AhmedAbdelbasit/ZUMAN-Robot/README.md

# ZUMAN-Robot
This repository will contain the full code and documentation of ZUMAN Robot. It is my graduation project. Here is the youtube playlist for its progress https://goo.gl/xKe8xR
