AhmedAbdelbasit/ZUMAN-Robot/Hardware/Required Arduino Libraries/Readme.txt

put these libraries at path:
	C:\Users\<user>\Documents\Arduino\libraries
	
ros_lib enables you to use ros messages in arduino ide
