AhmedAbdelbasit/ZUMAN-Robot/Documentation/Second version/Fig/Electronics/micro-servo.jpg

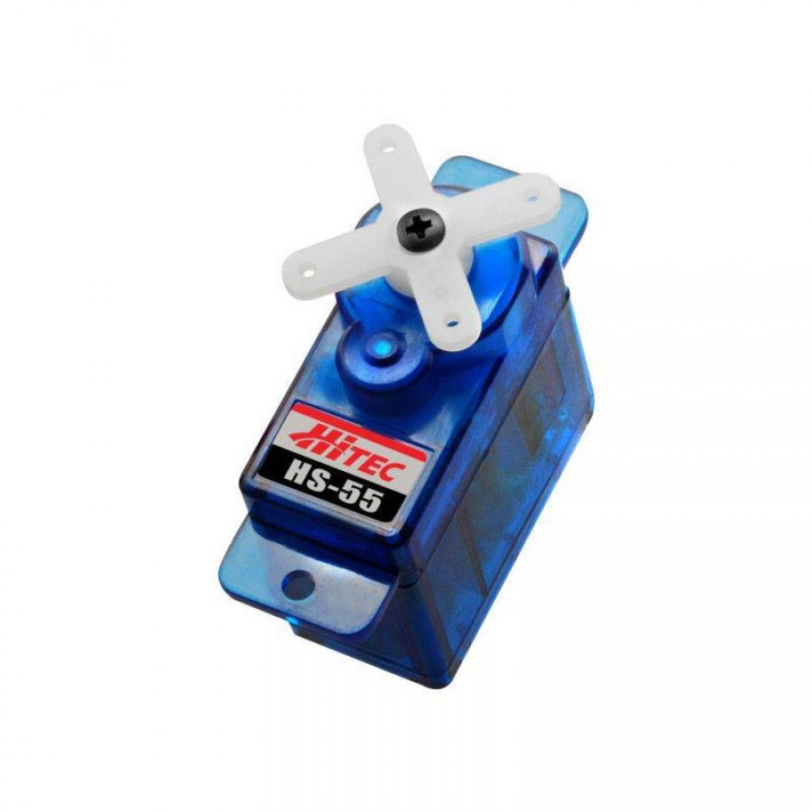
Documentation/Second version/Fig/Electronics/micro-servo.jpg
