AhmedAbdelbasit/ZUMAN-Robot/Documentation/Second version/Fig/Electronics/standard-servo.png

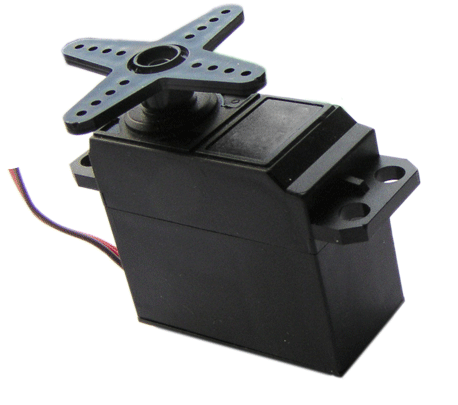
Documentation/Second version/Fig/Electronics/standard-servo.png
