AhmedAbdelbasit/ZUMAN-Robot/Documentation/Second version/Fig/hw-map.png

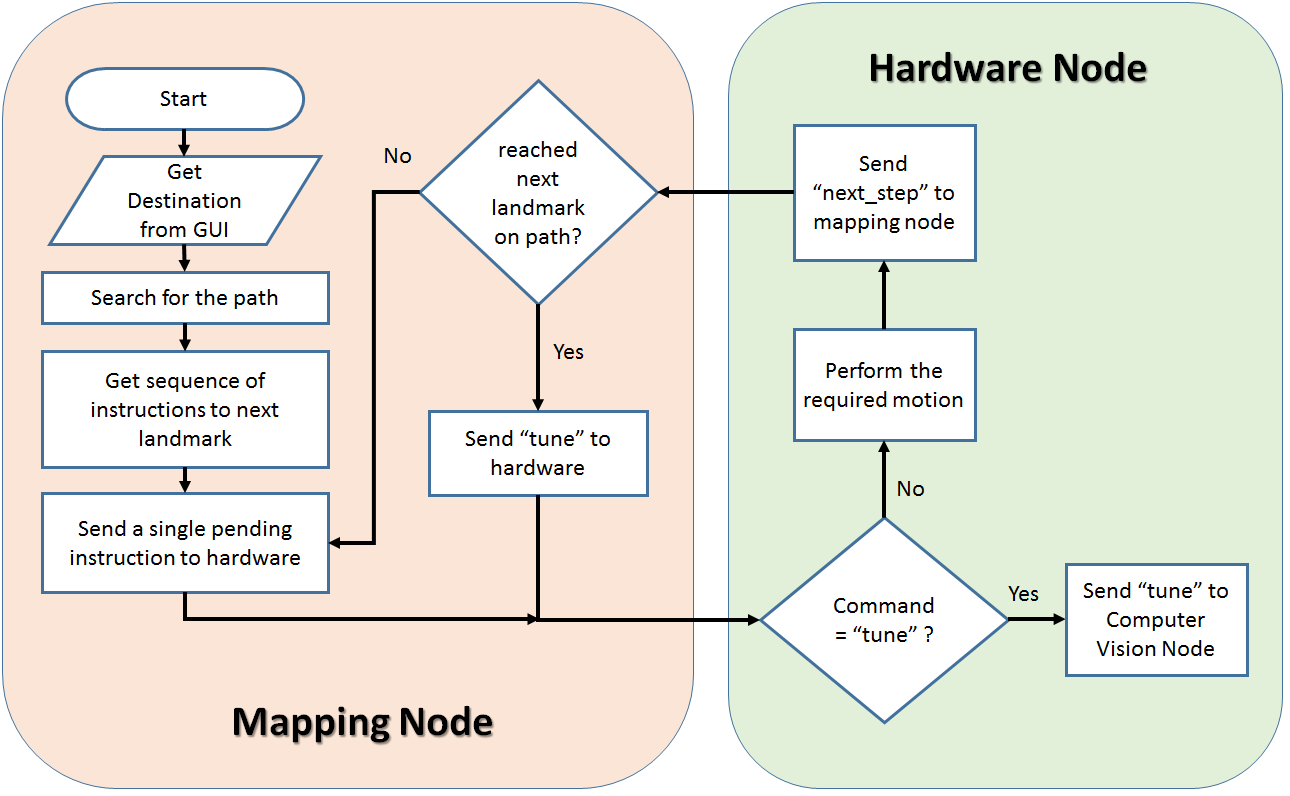
Documentation/Second version/Fig/hw-map.png
