AhmedAbdelbasit/ZUMAN-Robot/Documentation/Second version/Fig/solid/back-cover.png

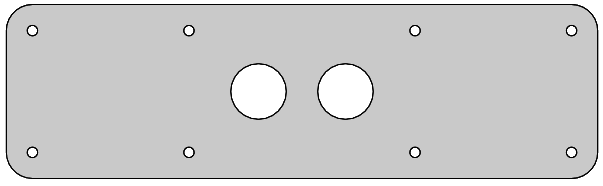
Documentation/Second version/Fig/solid/back-cover.png
