AhmedAbdelbasit/ZUMAN-Robot/Documentation/Second version/Fig/solid/front-cover.png

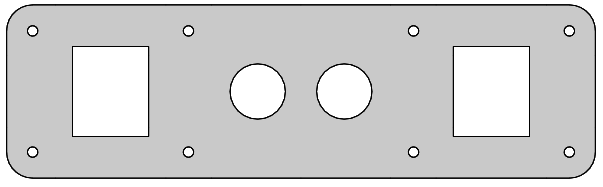
Documentation/Second version/Fig/solid/front-cover.png
