AhmedAbdelbasit/ZUMAN-Robot/Documentation/Second version/Fig/solid/front-frame-part.png

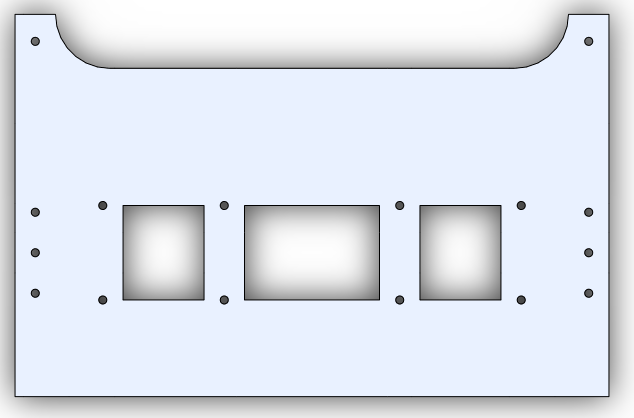
Documentation/Second version/Fig/solid/front-frame-part.png
