AhmedAbdelbasit/ZUMAN-Robot/Hardware/Solid Design/new car design/img/final_1.png

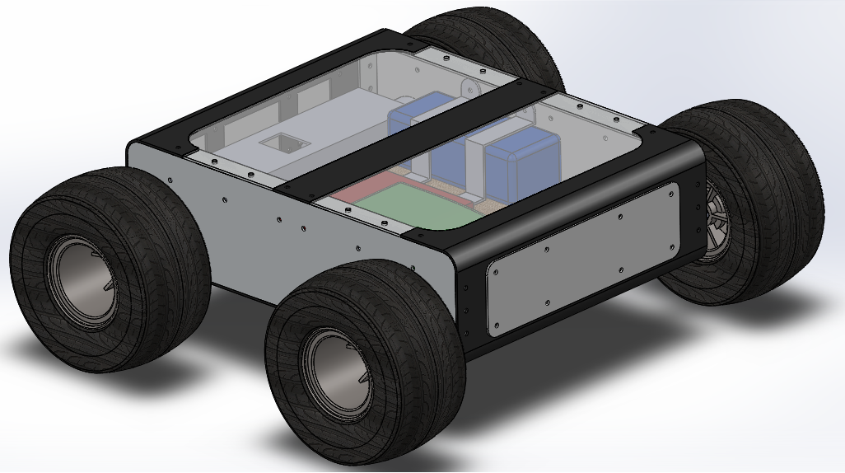
Hardware/Solid Design/new car design/img/final_1.png
