AhmedAbdelbasit/ZUMAN-Robot/Hardware/Solid Design/new car design/img/final_2.png

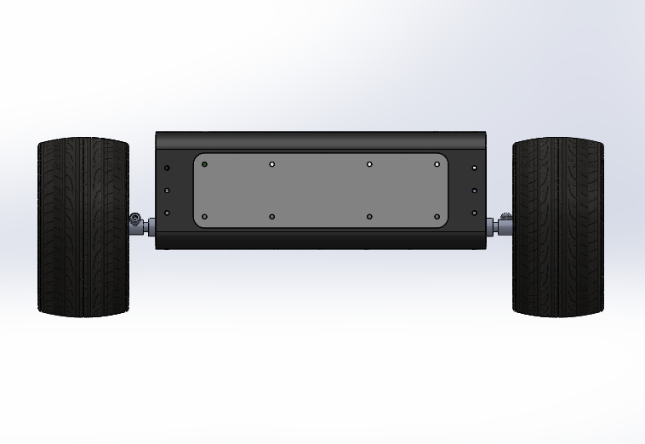
Hardware/Solid Design/new car design/img/final_2.png
