AhmedAbdelbasit/ZUMAN-Robot/Hardware/Solid Design/new car design/img/final_3.png

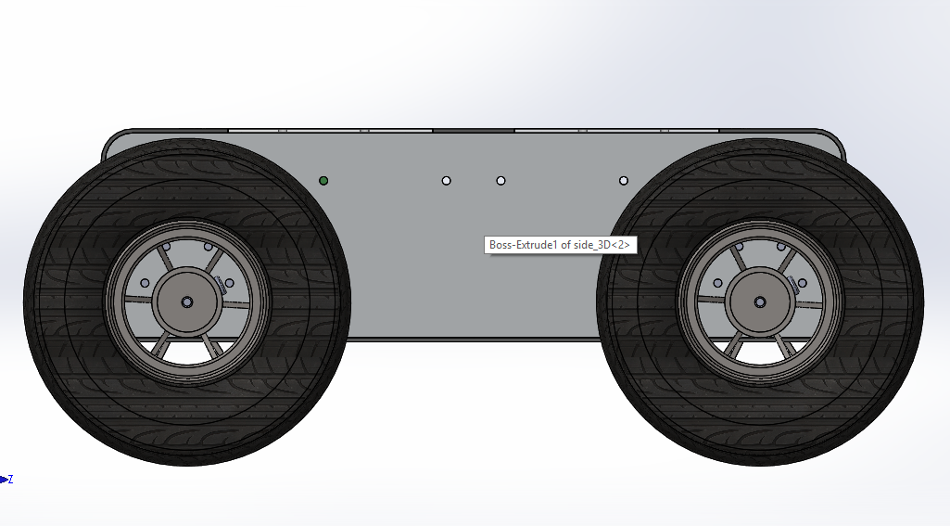
Hardware/Solid Design/new car design/img/final_3.png
