AhmedAbdelbasit/ZUMAN-Robot/Hardware/Solid Design/new car design/img/final_4.png

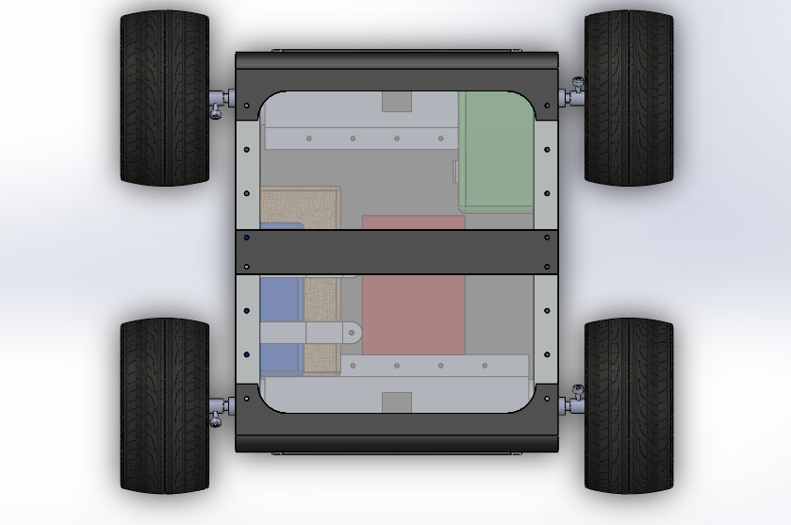
Hardware/Solid Design/new car design/img/final_4.png
