AhmedAbdelbasit/ZUMAN-Robot/Hardware/Solid Design/new car design/img/final_5.png

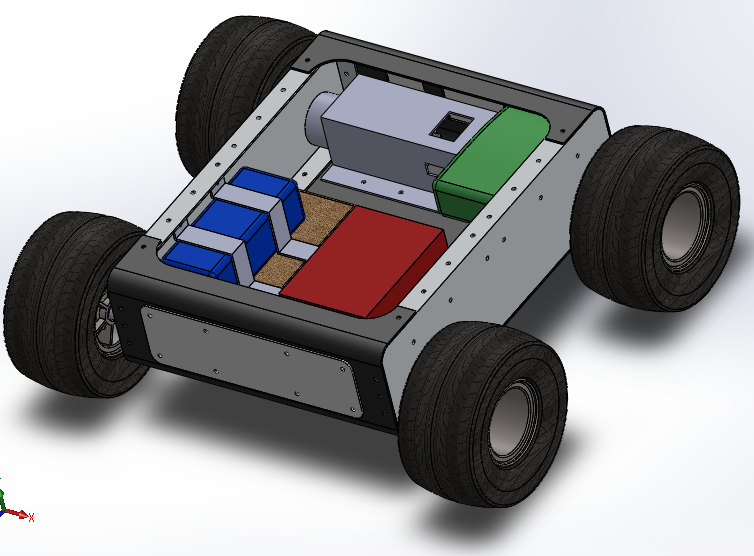
Hardware/Solid Design/new car design/img/final_5.png
