AhmedAbdelbasit/ZUMAN-Robot/Hardware/Solid Design/new car design/motor_wheel.SLDASM

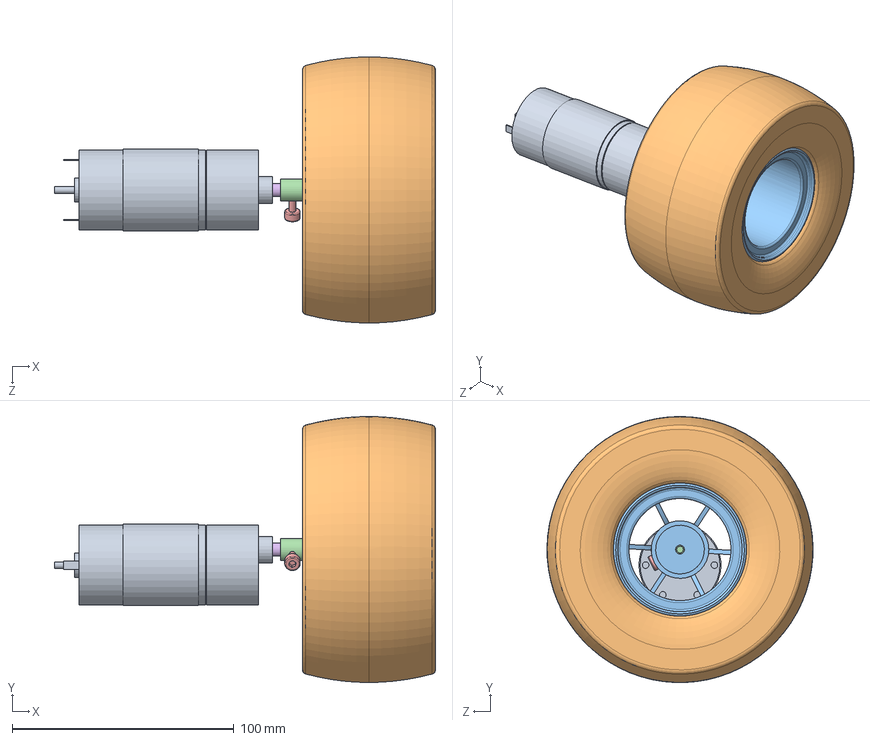
[picture p80: CAD file, 2017-07-04]
Hardware/Solid Design/new car design/motor_wheel.SLDASM
171.8 x 119.9 x 120.0 mm
Motor_30K_100rpm
big tyre
big wheel 12cm
coupler
coupler nail
big_motot_shaft
