AhmedAbdelbasit/ZUMAN-Robot/Hardware/Solid Design/new car design/Assem1.SLDASM

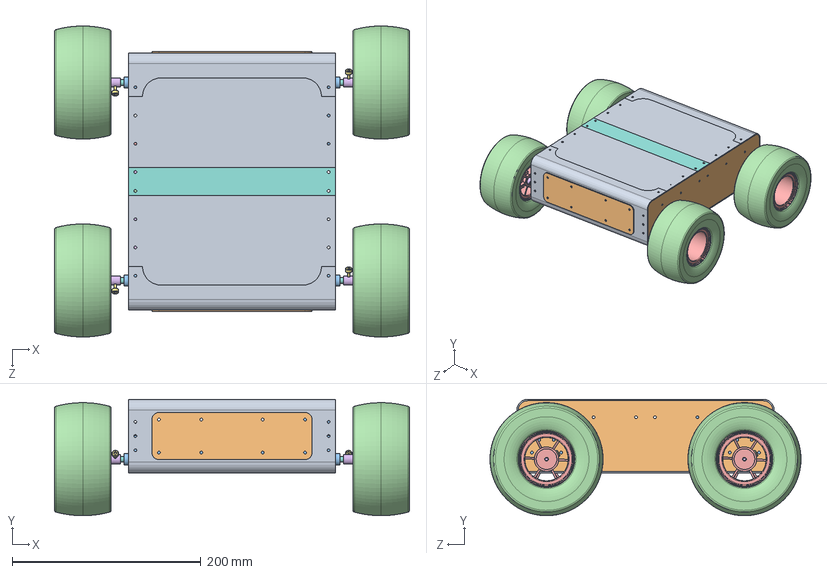
[picture p81: CAD file, 2017-07-04]
Hardware/Solid Design/new car design/Assem1.SLDASM
376.6 x 123.5 x 330.0 mm
frame_3d
side_3D x 2
Motor_30K_100rpm x 4
big tyre x 4
big wheel 12cm x 4
coupler x 4
coupler nail x 4
big_motot_shaft x 4
driver circuit
motor cover x 2
raspberry pi
battery cover x 2
powerbank
battery_12v
top battery holder
contact part
top cover x 2
front cover x 2
