AhmedAbdelbasit/ZUMAN-Robot/Hardware/Solid Design/front.SLDPRT

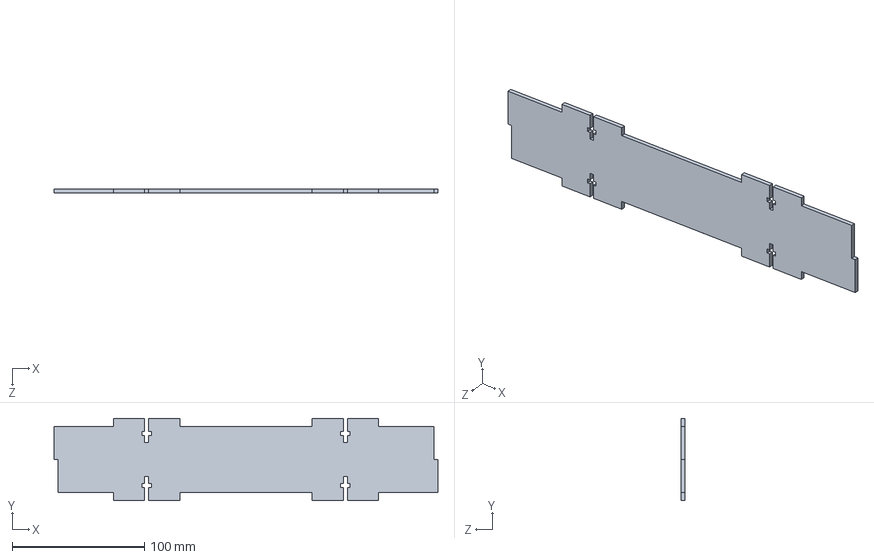
[picture p82: CAD file, 2017-06-24]
Hardware/Solid Design/front.SLDPRT
290.0 x 62.0 x 3.00 mm
