AhmedAbdelbasit/ZUMAN-Robot/Hardware/Solid Design/new car design/front cover.SLDPRT

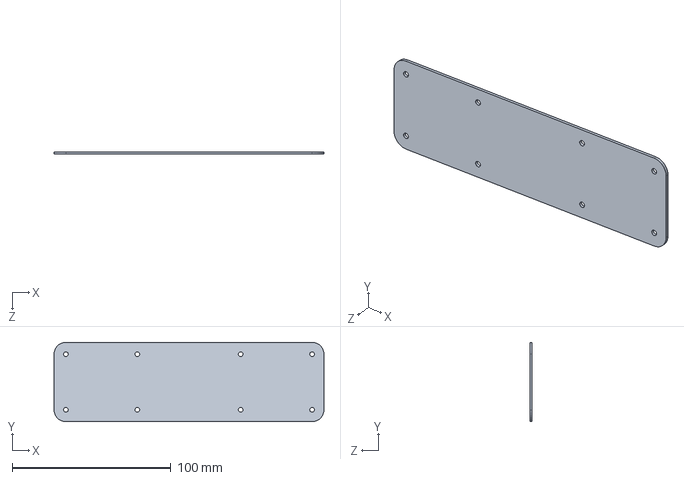
[picture p83: CAD file, 2017-07-04]
Hardware/Solid Design/new car design/front cover.SLDPRT
170.0 x 50.0 x 1.50 mm
