AhmedAbdelbasit/ZUMAN-Robot/Hardware/Solid Design/new car design/powerbank.SLDPRT

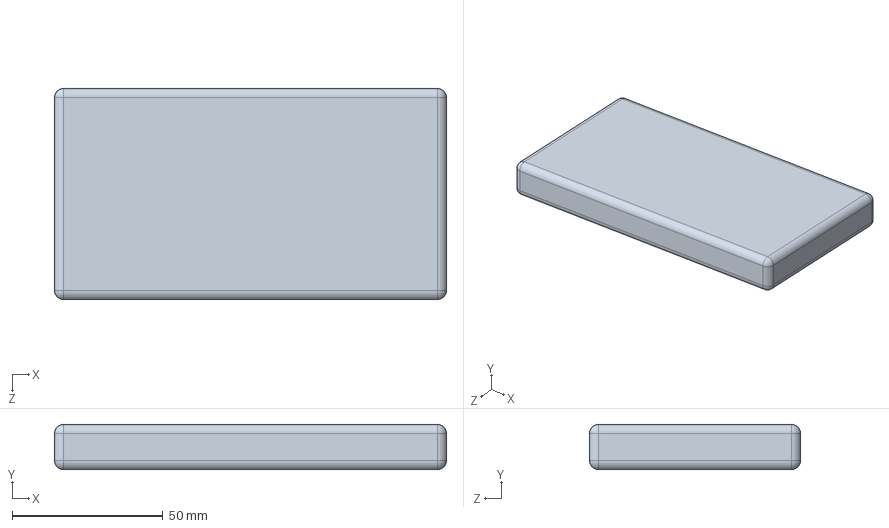
[picture p84: CAD file, 2017-07-04]
Hardware/Solid Design/new car design/powerbank.SLDPRT
130.0 x 15.0 x 70.0 mm
