AhmedAbdelbasit/ZUMAN-Robot/Hardware/Solid Design/new side.SLDPRT

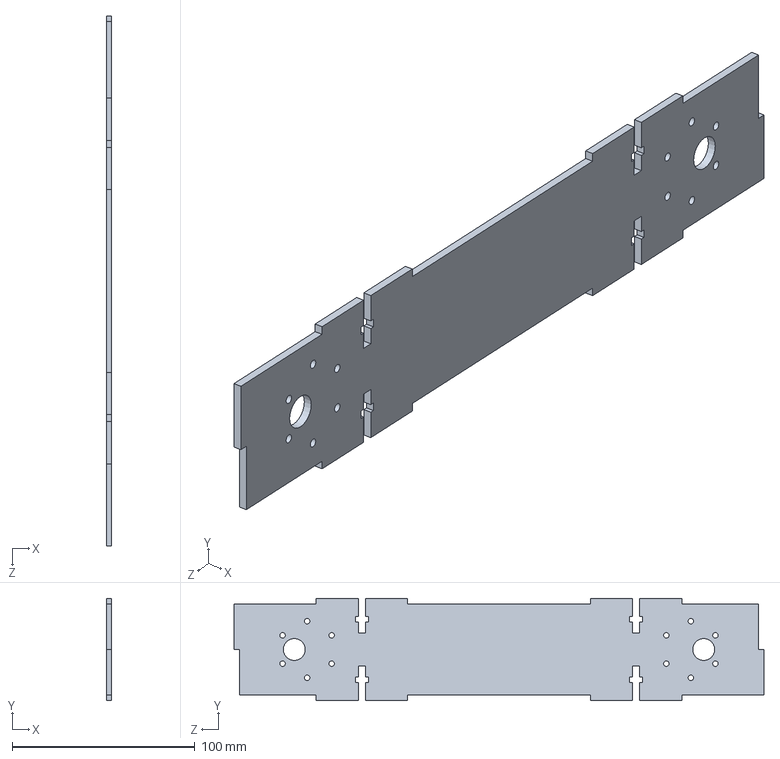
[picture p85: CAD file, 2017-06-24]
Hardware/Solid Design/new side.SLDPRT
3.00 x 56.0 x 290.0 mm
