AhmedAbdelbasit/ZUMAN-Robot/Hardware/Solid Design/big tyre.SLDPRT

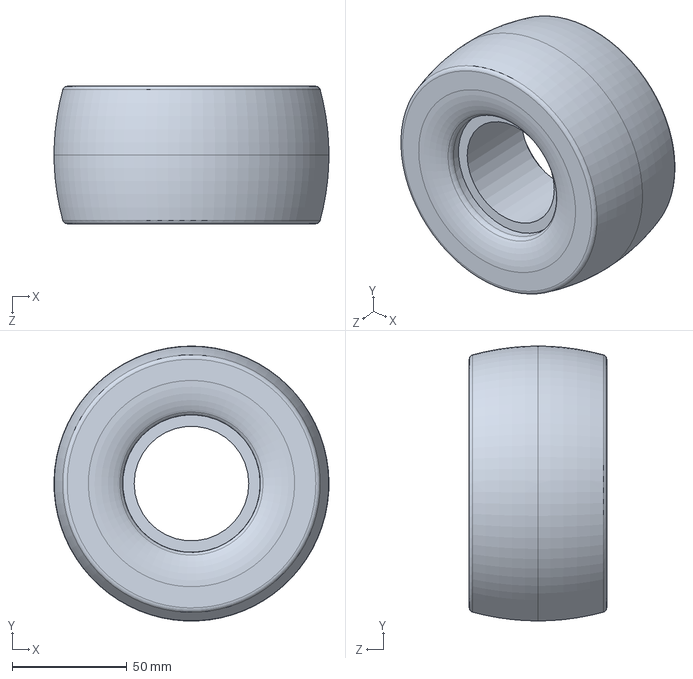
[picture p86: CAD file, 2017-06-24]
Hardware/Solid Design/big tyre.SLDPRT
120.0 x 119.9 x 60.0 mm
