AhmedAbdelbasit/ZUMAN-Robot/Hardware/Solid Design/new car design/battery cover.SLDPRT

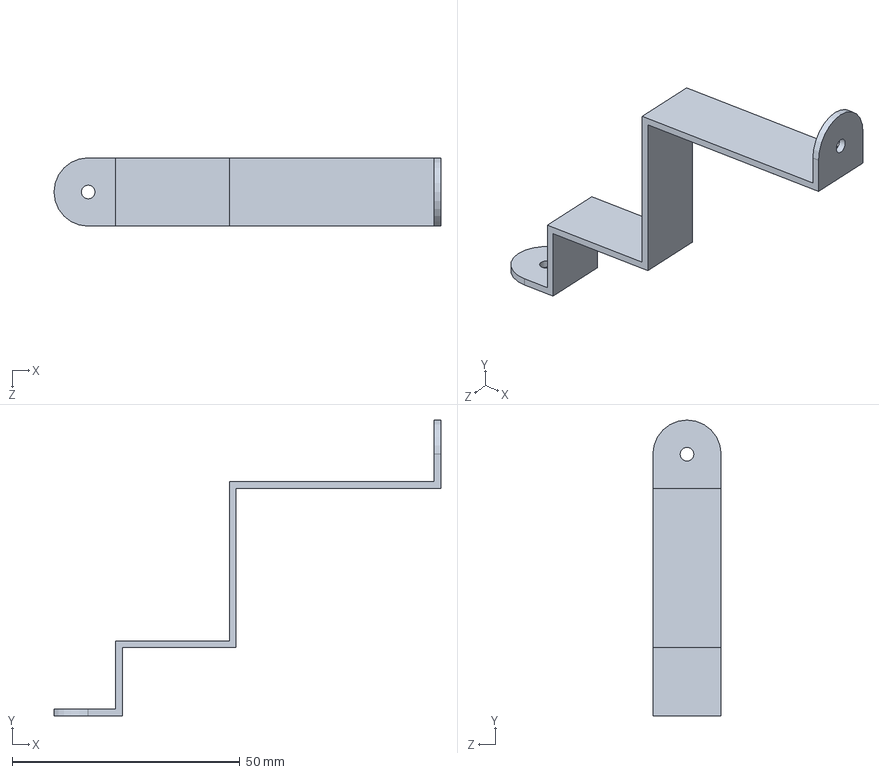
[picture p87: CAD file, 2017-07-04]
Hardware/Solid Design/new car design/battery cover.SLDPRT
85.0 x 65.0 x 15.0 mm
