AhmedAbdelbasit/ZUMAN-Robot/Hardware/Solid Design/motor support.SLDPRT

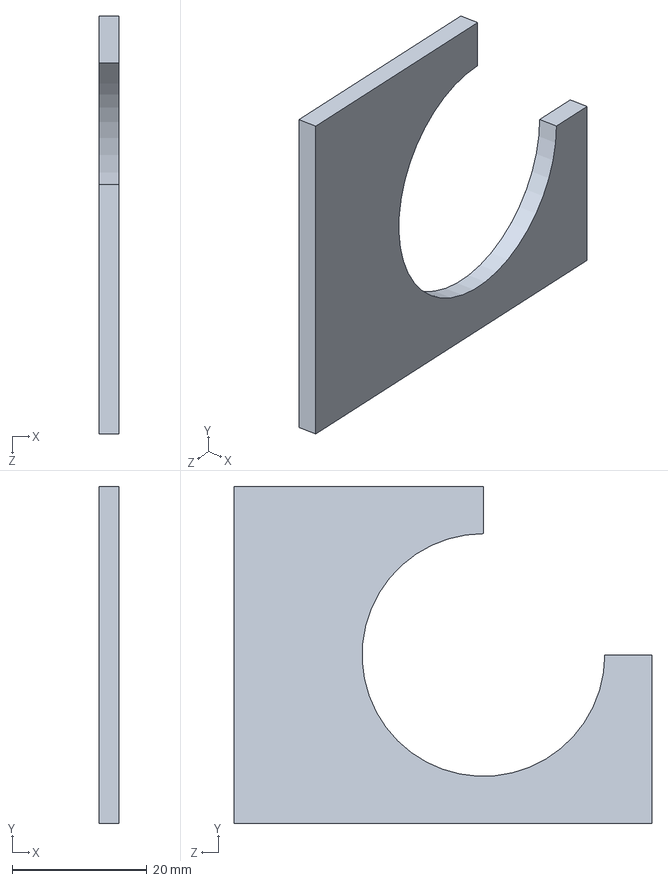
[picture p88: CAD file, 2017-06-24]
Hardware/Solid Design/motor support.SLDPRT
3.00 x 50.0 x 62.0 mm
