AhmedAbdelbasit/ZUMAN-Robot/Hardware/Solid Design/new car design/raspberry pi.SLDPRT

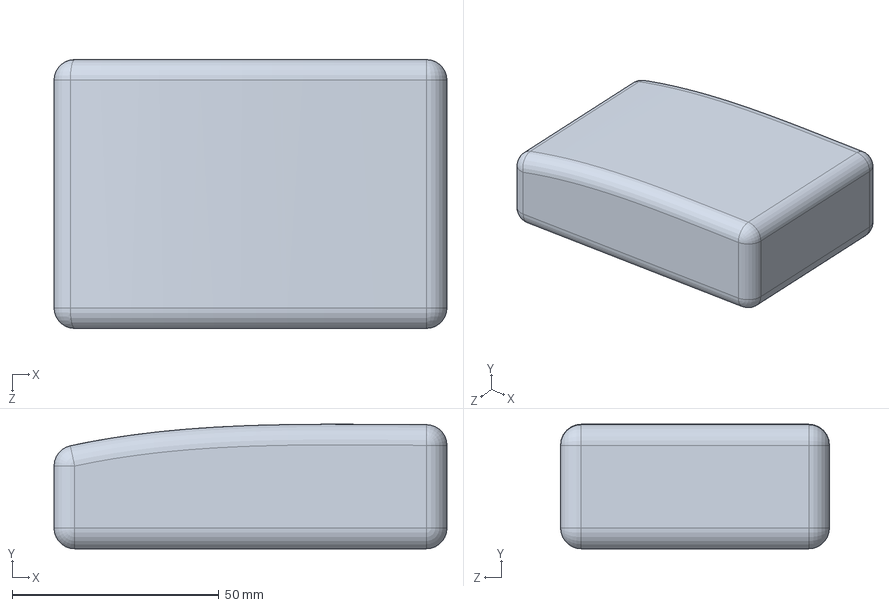
[picture p89: CAD file, 2017-07-04]
Hardware/Solid Design/new car design/raspberry pi.SLDPRT
95.0 x 30.1 x 65.0 mm
