AhmedAbdelbasit/ZUMAN-Robot/Hardware/Solid Design/new car design/motor cover.SLDPRT

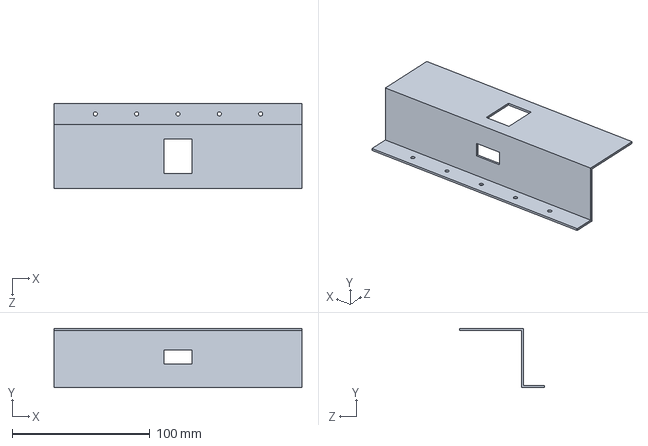
[picture p90: CAD file, 2017-07-04]
Hardware/Solid Design/new car design/motor cover.SLDPRT
180.0 x 43.0 x 61.5 mm
