AhmedAbdelbasit/ZUMAN-Robot/Hardware/Solid Design/top support.SLDPRT

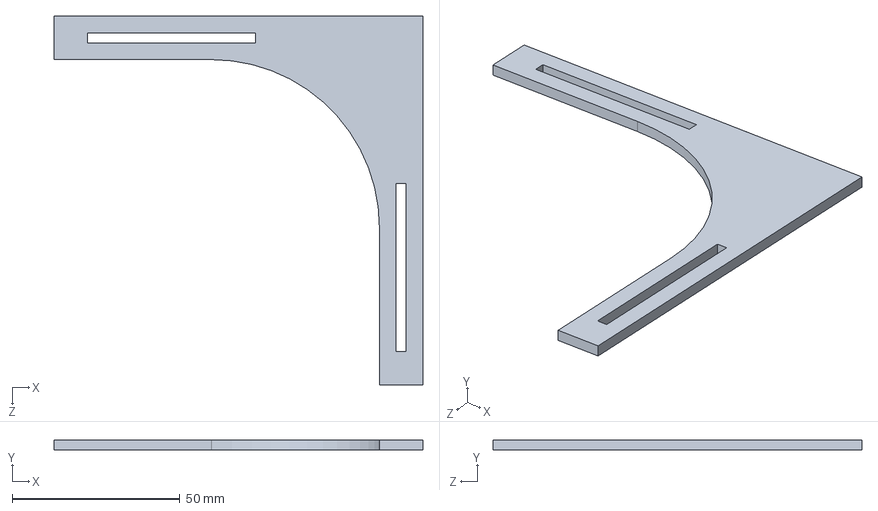
[picture p91: CAD file, 2017-06-24]
Hardware/Solid Design/top support.SLDPRT
110.0 x 3.00 x 110.0 mm
