AhmedAbdelbasit/ZUMAN-Robot/Hardware/Solid Design/Base.SLDPRT

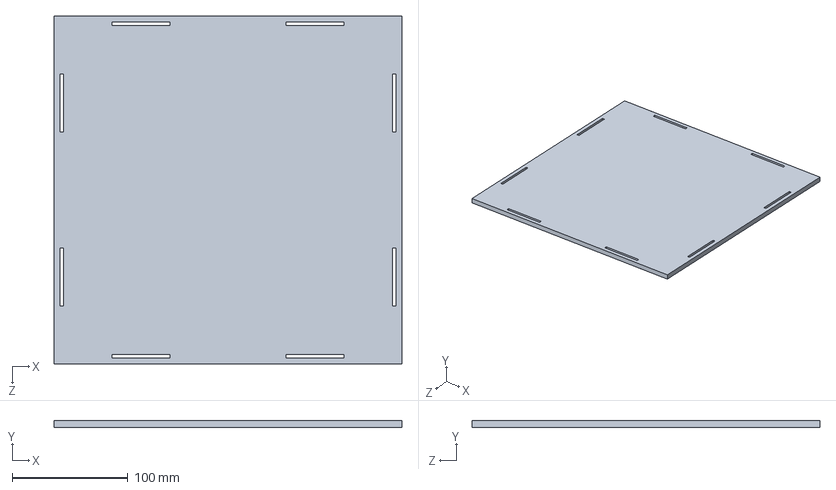
[picture p92: CAD file, 2017-06-24]
Hardware/Solid Design/Base.SLDPRT
300.0 x 6.00 x 300.0 mm
