AhmedAbdelbasit/ZUMAN-Robot/Hardware/Solid Design/new car design/top battery holder.SLDPRT

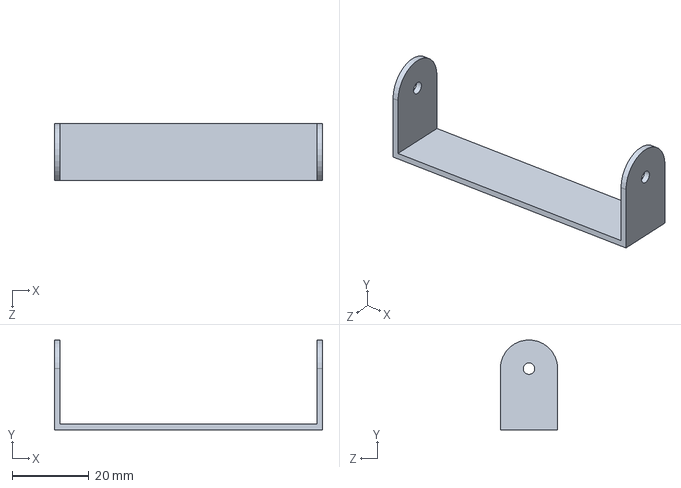
[picture p93: CAD file, 2017-07-04]
Hardware/Solid Design/new car design/top battery holder.SLDPRT
70.0 x 23.5 x 15.0 mm
