AhmedAbdelbasit/ZUMAN-Robot/Hardware/Solid Design/big wheel 12cm.SLDPRT

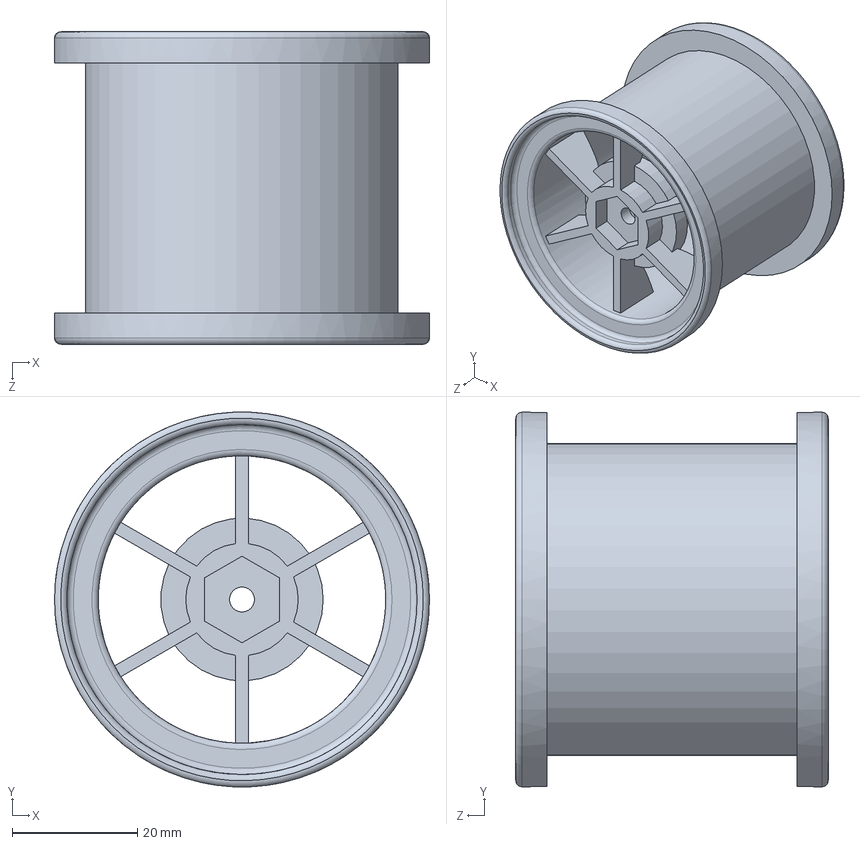
[picture p94: CAD file, 2017-06-24]
Hardware/Solid Design/big wheel 12cm.SLDPRT
60.0 x 59.9 x 50.0 mm
