AhmedAbdelbasit/ZUMAN-Robot/Hardware/Solid Design/new car design/battery_12v.SLDPRT

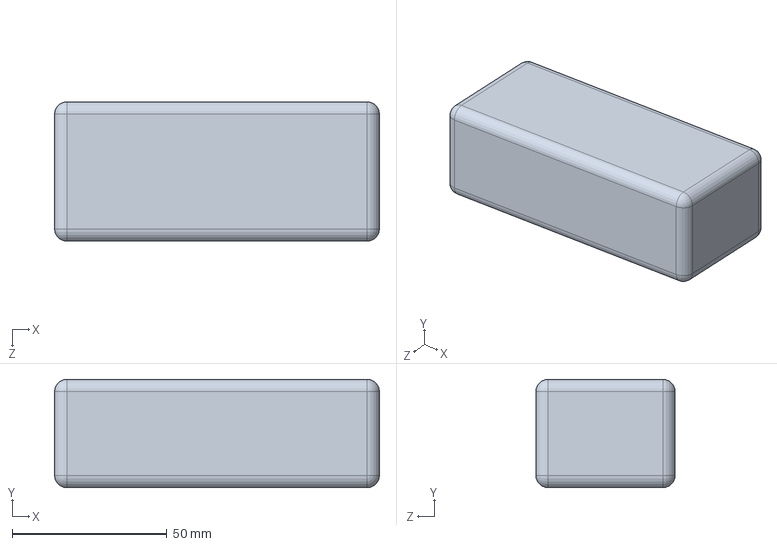
[picture p95: CAD file, 2017-07-04]
Hardware/Solid Design/new car design/battery_12v.SLDPRT
105.0 x 35.0 x 45.0 mm
