AhmedAbdelbasit/ZUMAN-Robot/Hardware/Solid Design/new car design/frame_3d.SLDPRT

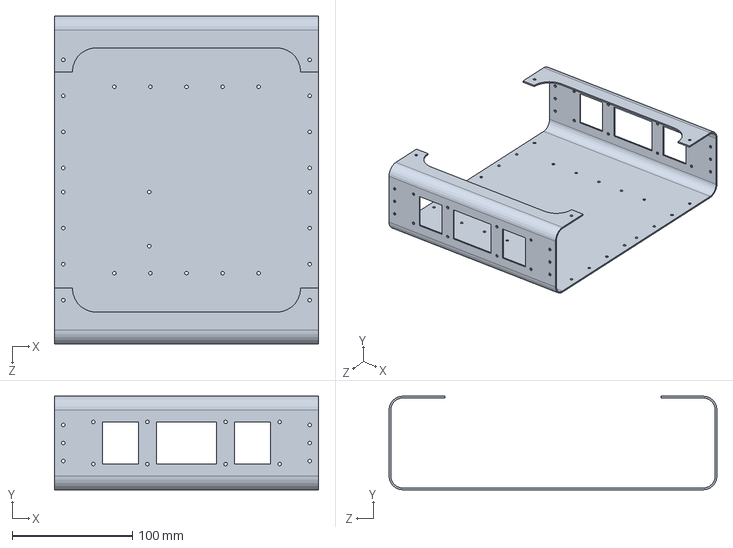
[picture p96: CAD file, 2017-07-04]
Hardware/Solid Design/new car design/frame_3d.SLDPRT
220.0 x 78.0 x 273.0 mm
