AhmedAbdelbasit/ZUMAN-Robot/Hardware/Solid Design/new car design/side_3D.SLDPRT

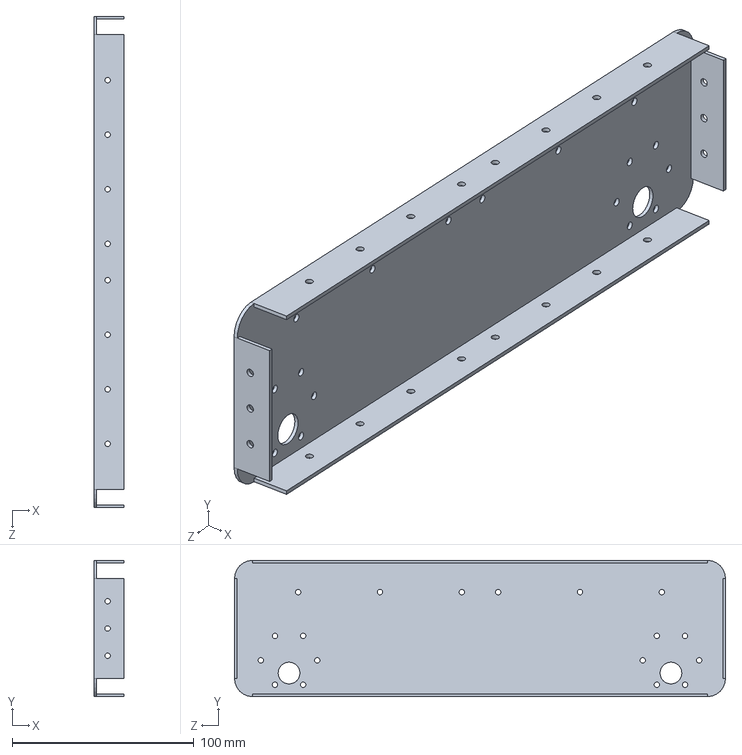
[picture p97: CAD file, 2017-07-04]
Hardware/Solid Design/new car design/side_3D.SLDPRT
16.5 x 75.0 x 270.0 mm
