AhmedAbdelbasit/ZUMAN-Robot/Hardware/Solid Design/new car design/driver circuit.SLDPRT

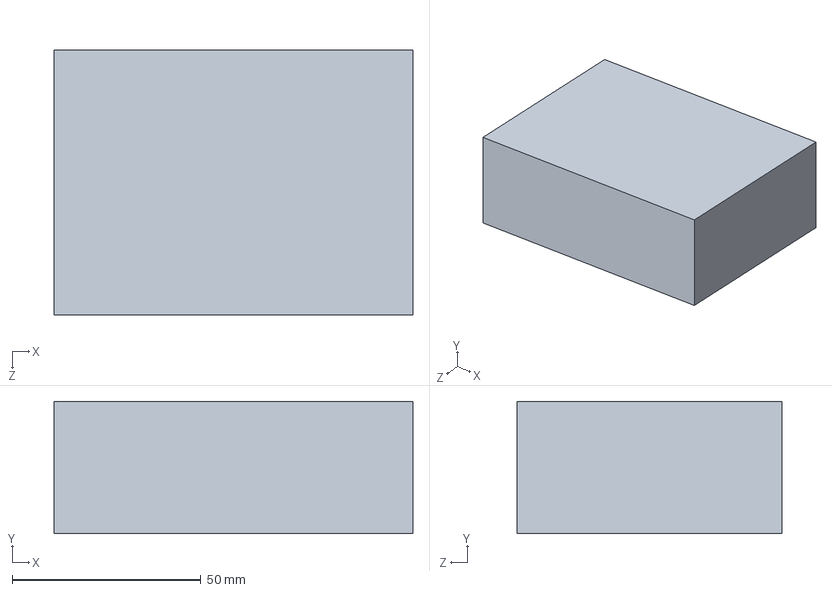
[picture p98: CAD file, 2017-07-04]
Hardware/Solid Design/new car design/driver circuit.SLDPRT
95.0 x 35.0 x 70.0 mm
