AhmedAbdelbasit/ZUMAN-Robot/Hardware/Solid Design/new car design/contact part.SLDPRT

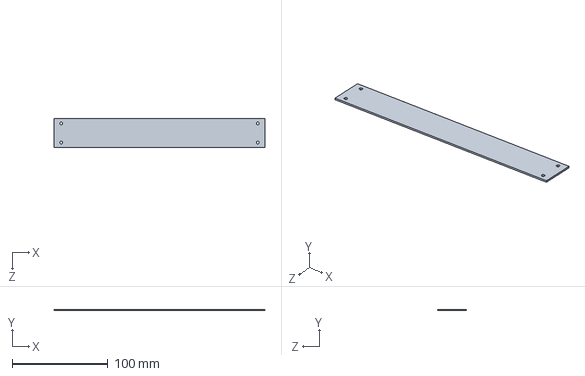
[picture p99: CAD file, 2017-07-04]
Hardware/Solid Design/new car design/contact part.SLDPRT
220.0 x 1.50 x 30.0 mm
