AhmedAbdelbasit/ZUMAN-Robot/Hardware/Solid Design/new car design/top cover.SLDPRT

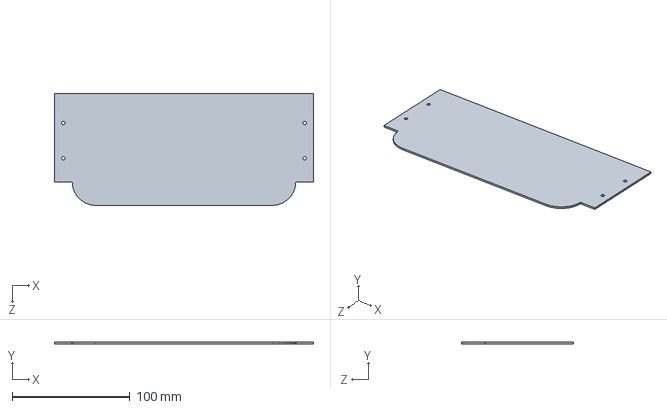
[picture p100: CAD file, 2017-07-04]
Hardware/Solid Design/new car design/top cover.SLDPRT
220.0 x 1.50 x 95.0 mm
