AhmedAbdelbasit/ZUMAN-Robot/Hardware/Solid Design/new car design/coupler.SLDPRT

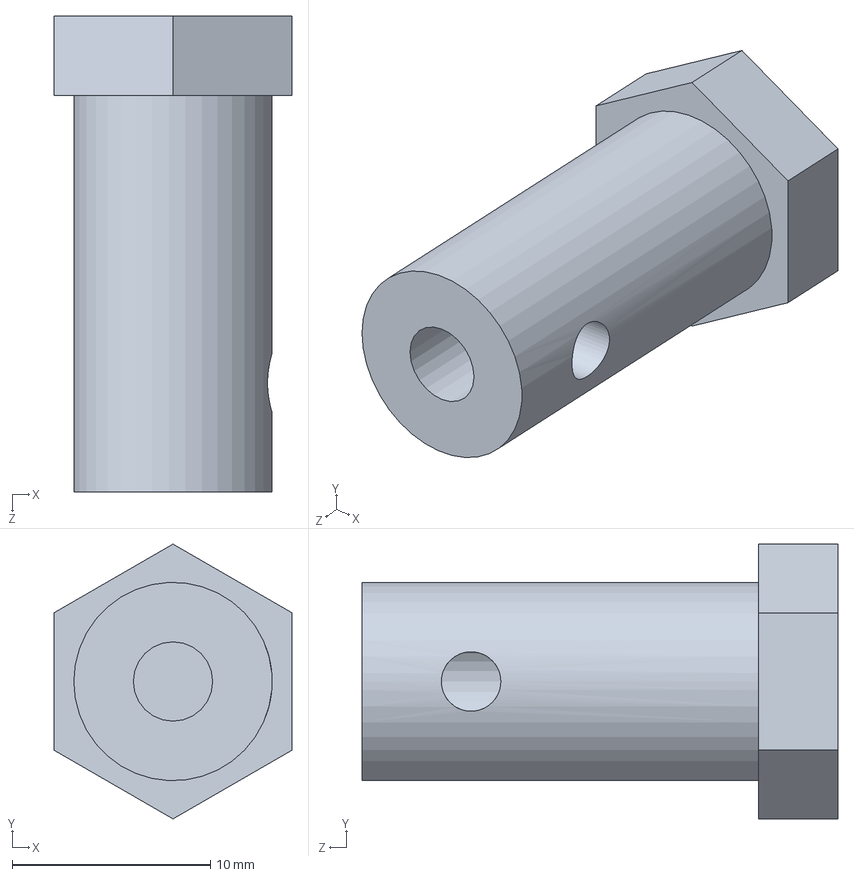
[picture p101: CAD file, 2017-06-24]
Hardware/Solid Design/new car design/coupler.SLDPRT
12.0 x 13.9 x 24.0 mm
