AhmedAbdelbasit/ZUMAN-Robot/Hardware/Solid Design/new car design/coupler nail.SLDPRT

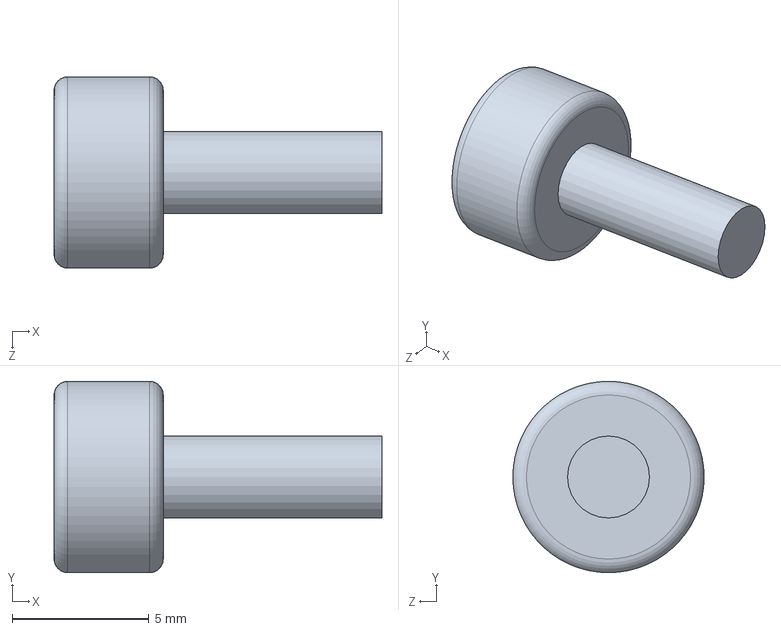
[picture p102: CAD file, 2017-06-24]
Hardware/Solid Design/new car design/coupler nail.SLDPRT
12.0 x 7.00 x 7.00 mm
