AhmedAbdelbasit/ZUMAN-Robot/Hardware/Solid Design/new car design/Motor_30K_100rpm.SLDPRT

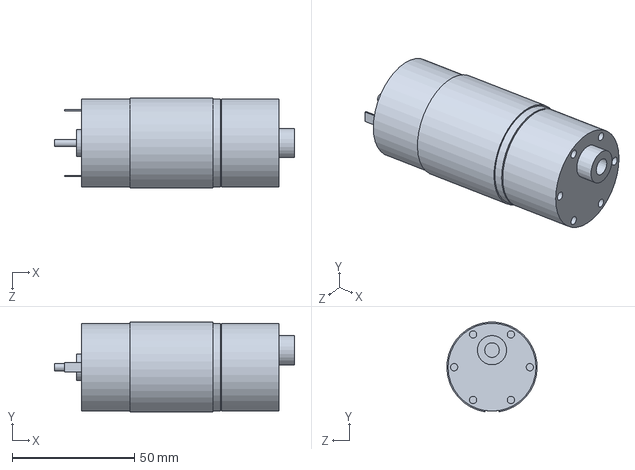
[picture p103: CAD file, 2017-06-24]
Hardware/Solid Design/new car design/Motor_30K_100rpm.SLDPRT
98.3 x 36.7 x 37.0 mm
