AhmedAbdelbasit/ZUMAN-Robot/Hardware/Solid Design/new car design/big_motot_shaft.SLDPRT

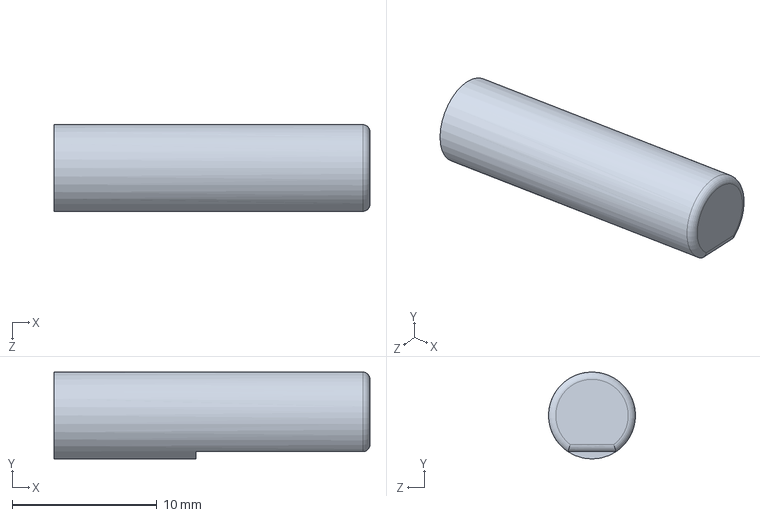
[picture p104: CAD file, 2017-06-24]
Hardware/Solid Design/new car design/big_motot_shaft.SLDPRT
21.8 x 6.00 x 6.00 mm
