AhmedAbdelbasit/ZUMAN-Robot/(list of files, cad)

Other CAD files:
Hardware/Solid Design/new car design/big wheel 12cm.SLDPRT
Hardware/Solid Design/new car design/big tyre.SLDPRT
