AhmedAbdelbasit/ZUMAN-Robot/Hardware/Required Arduino Libraries/ros_lib/zuman_msgs/Qlandmark.h

#ifndef _ROS_zuman_msgs_Qlandmark_h
#define _ROS_zuman_msgs_Qlandmark_h

#include <stdint.h>
#include <string.h>
#include <stdlib.h>
#include "ros/msg.h"

namespace zuman_msgs
{

  class Qlandmark : public ros::Msg
  {
    public:
      typedef uint8_t _type_type;
      _type_type type;
      typedef float _data_type;
      _data_type data;

    Qlandmark():
      type(0),
      data(0)
    {
    }

    virtual int serialize(unsigned char *outbuffer) const
    {
      int offset = 0;
      *(outbuffer + offset + 0) = (this->type >> (8 * 0)) & 0xFF;
      offset += sizeof(this->type);
      union {
        float real;
        uint32_t base;
      } u_data;
      u_data.real = this->data;
      *(outbuffer + offset + 0) = (u_data.base >> (8 * 0)) & 0xFF;
      *(outbuffer + offset + 1) = (u_data.base >> (8 * 1)) & 0xFF;
      *(outbuffer + offset + 2) = (u_data.base >> (8 * 2)) & 0xFF;
      *(outbuffer + offset + 3) = (u_data.base >> (8 * 3)) & 0xFF;
      offset += sizeof(this->data);
      return offset;
    }

    virtual int deserialize(unsigned char *inbuffer)
    {
      int offset = 0;
      this->type =  ((uint8_t) (*(inbuffer + offset)));
      offset += sizeof(this->type);
      union {
        float real;
        uint32_t base;
      } u_data;
      u_data.base = 0;
      u_data.base |= ((uint32_t) (*(inbuffer + offset + 0))) << (8 * 0);
      u_data.base |= ((uint32_t) (*(inbuffer + offset + 1))) << (8 * 1);
      u_data.base |= ((uint32_t) (*(inbuffer + offset + 2))) << (8 * 2);
      u_data.base |= ((uint32_t) (*(inbuffer + offset + 3))) << (8 * 3);
      this->data = u_data.real;
      offset += sizeof(this->data);
     return offset;
    }

    const char * getType(){ return "zuman_msgs/Qlandmark"; };
    const char * getMD5(){ return "83dc3cc30ffd32a96b55fd4a6df3dc72"; };

  };

}
#endif
