AhmedAbdelbasit/ZUMAN-Robot/Hardware/Arduino codes/Try and Test/Control tries/bluetooth_encoder_pid_speed_position_rosnode/Main_Loop.ino

void loop() {
  Time_Now = millis();
  if(Time_Now - Last_Tic >= Sample_Time ){
    Last_Tic = Time_Now;

    filterReading();

    if(Dir != 'S' && !Manned_Mode)
      controlSpeed();
      
    filterMotorSpeed();
    if(!Manned_Mode){
      checkGoal();
    }
    
    driveMotor();
  }
  nh.spinOnce();
}
