AhmedAbdelbasit/ZUMAN-Robot/Hardware/Arduino codes/Try and Test/Control tries/bluetooth_encoder_pid_US/Main_Loop.ino

void loop() {
  Time_Now = millis();
  if(Time_Now - Last_Tic >= Sample_Time ){
    Last_Tic = Time_Now;
    
    if(Serial.available() > 0){
      Temp_Msg = Serial.read();
    }
    
    if (Temp_Msg == 'E'){
      stopMotion();
      Dir = 'S';
      startDebug();
      Temp_Msg = 'S';
    }else{
      Dir = Temp_Msg;
      takeReadings();
      setMotorSpeed();
      driveMotors();
    }
    Serial.print(Right_Distance);
    Serial.print("\t\t");
    Serial.print(Measured_Left_Speed);
    Serial.print("\t\t");
    Serial.println(Measured_Right_Speed);
    //Serial.println("###################################");
  }else{
    //Serial.println("IDLE");
  }
}
