AhmedAbdelbasit/ZUMAN-Robot/Hardware/Arduino codes/Try and Test/Control tries/bluetooth_encoder_pid_speed_position_rosnode/bluetooth_encoder_pid_speed_position_rosnode.ino

#include <ros.h>
#include <zuman_msgs/Instruction.h>

// CH1
#define Front_Right_Dir 10
#define Front_Right_PWM 11
#define Front_Right_INT 3
#define Front_Right_Cur A1

//CH2
#define Front_Left_Dir 8
#define Front_Left_PWM 9
#define Front_Left_INT 2
#define Front_Left_Cur A2

// CH3
#define Back_Right_Dir 7
#define Back_Right_PWM 6

// CH4
#define Back_Left_Dir 4
#define Back_Left_PWM 5

#define Sample_Time 50.0
#define Distance_Per_Rev 38.73

#define Light_Pin 12
boolean Manned_Mode = LOW;

volatile int Left_Encoder_Ticks=0;
volatile int Right_Encoder_Ticks=0;

boolean Move_Ack = LOW;
float Goal_Distance = 0;
boolean Rotate_Ack = LOW;
float Rotation_Tick = 0; // 107 per 90 degrees


// Left-Side Motors Control
volatile float Measured_Left_Speed = 0;
volatile long Last_Left_Tick;
float Error_Left = 0;
float Last_Error_Left = 0;
float Error_Sum_Left = 0;
int Back_Left_Speed = 0;
int Front_Left_Speed = 0;

// Right-Side Motors Control
volatile float Measured_Right_Speed = 0;
volatile long Last_Right_Tick;
float Error_Right = 0;
float Last_Error_Right = 0;
float Error_Sum_Right = 0;
int Back_Right_Speed = 0;
int Front_Right_Speed = 0;

float Robot_Speed = 50;
float Filter_Speed_Constant = 0.1;
int Filtered_Left_Speed = 0;
int Filtered_Right_Speed = 0;

float Filter_Read_Constant = 0.1;
float Filtered_Right_Read = 0;
float Filtered_Left_Read = 0;

// Cycle
long Last_Tic;
long Time_Now;

char Dir='S';

// PID Parameters
float Kp_S= 2;
float Ki_S= 2;
float Kd_S= 0.5;


ros::NodeHandle nh;
zuman_msgs::Instruction hw_msg;
ros::Publisher info_Pub("hw_low", &hw_msg);
void inst_CB(const zuman_msgs::Instruction& msg) {
  
  if( String(msg.command) == String("light_on")){
    digitalWrite(Light_Pin, HIGH);
  }else if( String(msg.command) == String("light_off")){
    digitalWrite(Light_Pin, LOW);
    
  }else if ( String(msg.command) == String("map_move") || String(msg.command) == String("cv_move")  ){
    Error_Sum_Left = 0;
    Error_Sum_Right = 0;
    Last_Error_Left = 0;
    Last_Error_Right = 0;

    Goal_Distance = msg.arg1;
    Dir = 'F';
    int Ticks = floor(Goal_Distance*180.0/Distance_Per_Rev);
    if(Ticks < 0)
      Dir = 'B';
      
    Right_Encoder_Ticks = abs(Ticks);
    Left_Encoder_Ticks = abs(Ticks);
    Move_Ack = HIGH;
    
  }else if (String(msg.command) == String("map_rotate")  || String(msg.command) == String("cv_rotate")){
    Error_Sum_Left = 0;
    Error_Sum_Right = 0;
    Last_Error_Left = 0;
    Last_Error_Right = 0;

    Rotation_Tick = msg.arg1;
    if(Rotation_Tick >0){
      Dir = 'L';
    }else{
      Dir = 'R';
    }
    
    Right_Encoder_Ticks = abs(Rotation_Tick);
    Left_Encoder_Ticks = abs(Rotation_Tick);
      
    //int Ticks = floor(Goal_Angle*180.0/Distance_Per_Rev);
    
    //Right_Encoder_Ticks = abs(Ticks);
    //Left_Encoder_Ticks = abs(Ticks);
    Rotate_Ack = HIGH;
  }else if(String(msg.command) == String("start_manned")){
    Manned_Mode = HIGH;
  }else if(String(msg.command) == String("end_manned")){
    Manned_Mode = LOW;
  }else if(String(msg.command) == String("set_pwm")){
    if(Manned_Mode){
      int left = msg.arg1;
      int right = msg.arg2;
      if(left >=0 && right >=0)
        Dir = 'F';
      else if(left <0 && right <0)
        Dir = 'B';
      else if(left >=0 && right <0)
        Dir = 'R';
      else if(left <0 && right >=0)
        Dir = 'L';
      else if(left <0 && right >=0)
        Dir = 'S';
      
      Front_Left_Speed = abs(msg.arg1) ;
      Front_Right_Speed = abs(msg.arg2) ;
    }
  }
  


  
  if ( String(msg.command) == String("map_move") || String(msg.command) == String("map_rotate") ){
    hw_msg.command = "done_map";
  }else if ( String(msg.command) == String("cv_move") || String(msg.command) == String("cv_rotate") ){
    hw_msg.command = "done_cv";
  }
  
}
ros::Subscriber<zuman_msgs::Instruction> inst_sub("hw_low", &inst_CB);


void setup() {
  
  pinMode(Back_Left_Dir,OUTPUT);
  pinMode(Back_Left_PWM,OUTPUT);
  pinMode(Back_Right_Dir,OUTPUT);
  pinMode(Back_Right_PWM,OUTPUT);
  pinMode(Front_Left_Dir,OUTPUT);
  pinMode(Front_Left_PWM,OUTPUT);
  pinMode(Front_Right_Dir,OUTPUT);
  pinMode(Front_Right_PWM,OUTPUT);
  
  pinMode(Front_Left_INT, INPUT);
  digitalWrite(Front_Left_INT, HIGH);
  pinMode(Front_Right_INT, INPUT);
  digitalWrite(Front_Right_INT, HIGH);
  delay(10);
  attachInterrupt(0, countLeft,FALLING);
  attachInterrupt(1, countRight,FALLING);

  pinMode(Light_Pin, OUTPUT);
  digitalWrite(Light_Pin,LOW);

  nh.initNode();
  nh.subscribe(inst_sub);
  nh.advertise(info_Pub);
  
  Last_Tic = (millis()/Sample_Time)*Sample_Time;
}
