AhmedAbdelbasit/ZUMAN-Robot/(commit log)

2017-06-24 custom messages added
    including Odometry, Qlandmark and Speeds for Hardware info
2017-06-24 Arduino codes added
2017-06-24 Hardware extra data
    Added Solid Design and Componets datasheet
    [Base.SLDPRT, Motor_30K_100rpm.SLDPRT, big tyre.SLDPRT, big wheel 12cm.SLDPRT, big_motot_shaft.SLDPRT, coupler nail.SLDPRT, coupler.SLDPRT, front.SLDPRT]
2017-06-28 HW changes
    changed:
    >> Sample Time
    >> Odometry relations
2017-07-04 ros HW_Node
    added :
    package zuman_hw
    arduino code for autonomous instructions
2017-07-04 New Desgin
    new solid design added
    [Assem1.SLDASM, Base.SLDPRT, Motor_30K_100rpm.SLDPRT, battery cover.SLDPRT, battery_12v.SLDPRT, big tyre.SLDPRT, big wheel 12cm.SLDPRT, big_motot_shaft.SLDPRT]
2017-07-07 sensor codes
    >> added more required libraries for sensors and arduino codes for
    testing sensors
    >> control methods and tries are added also
    >> all codes are to be unified soon
2017-07-08 changes in encoder speed measurement
2017-07-08 encoder codes
    some changes plus matlab plotting
2017-07-08 Encoder for Distance measurement
2017-07-08 single Robot Arduino Node
    both autonomous and Manned control deal with same node by different
    commands
2017-07-11 hardware changes
    HW node msgs flow
    Arduino Nodes
2017-07-11 Servo Cam added
2017-07-12 PID tuning
    some PID tuning and code debugging
2017-07-13 HW_Node Unified
    Best result for navigation process
    depends on PID speed control of motors on both sides and tracking the
    distance passed using encoders.
2017-07-14 Choosing DC motor
2017-07-15 Topics sub threads
2017-07-15 unified arduino manipulator rosnode
